revaldinotr/DigitPulse-dice/(list of files, drawings)

Other design files:
docs/dc-or-gate-wiring.pdsprj
