revaldinotr/DigitPulse-dice/docs/images/build/build-01.jpg

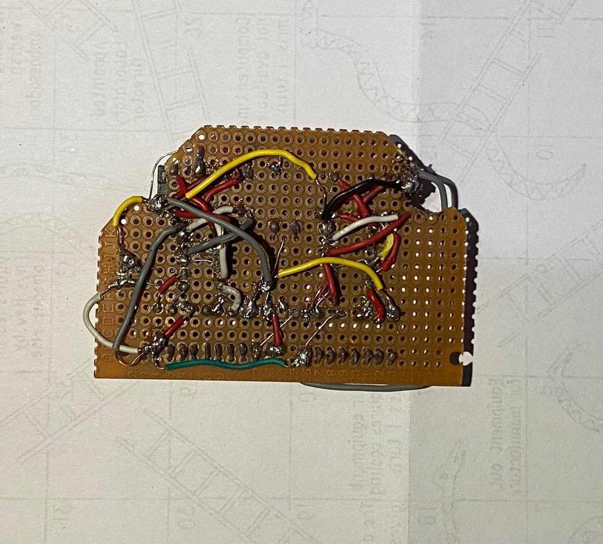
docs/images/build/build-01.jpg
