revaldinotr/DigitPulse-dice/docs/images/build/build-03.jpg

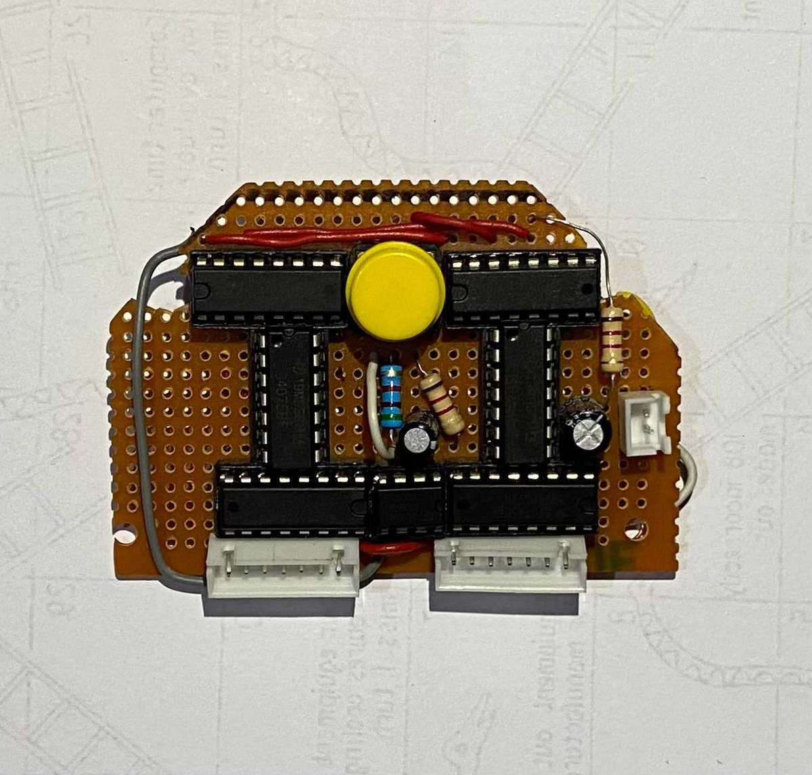
docs/images/build/build-03.jpg
