revaldinotr/DigitPulse-dice/docs/images/build/build-04.jpeg

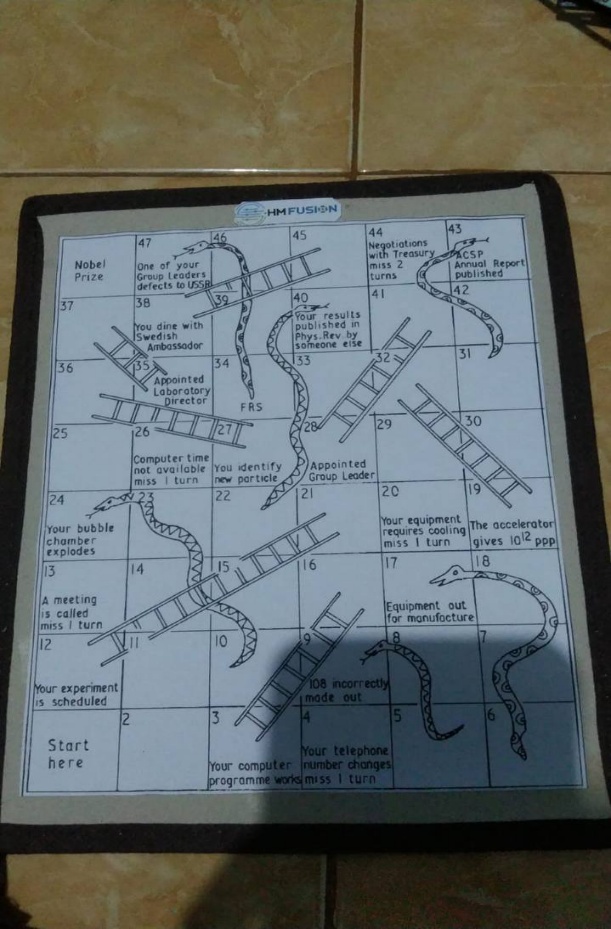
docs/images/build/build-04.jpeg
