revaldinotr/DigitPulse-dice/docs/images/build/build-05.jpg

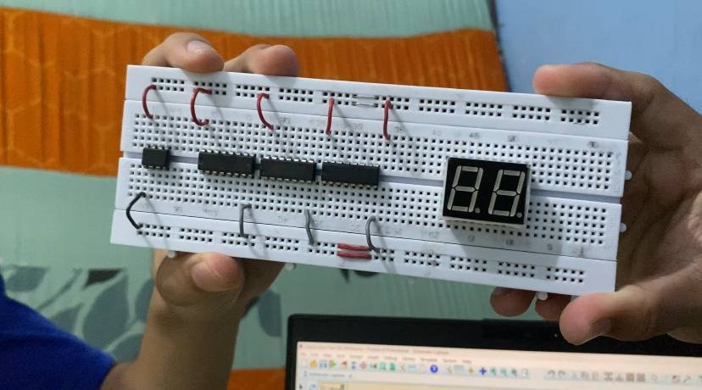
docs/images/build/build-05.jpg
